proconlon/EC463_Team_01_Polar_Eyes/(commit log)

2025-11-03 Fixes to github actions - all actions can now be run locally with act (caching included for downloads) - removed HCL from pi4 build process as packer doesn't have decent arm builders out there - So t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
2025-11-03 fixed arduino actions and fixed fw artifact check
2025-11-03 fix to arduino build dir for artifact
2025-11-06 Updated to a better local img build process - moved img building code out of github actions file into a separate bash script - can now build using local_builder.sh, act/local github actions, or using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
2025-11-21 feat: full demo version of arduino always-on device (#5)
2026-04-30 update Spring 26 - Moved Pi 5 scripts to new worker_pi_five/ directory - Renamed Arduino folder to sentry_itsybitsy/ for hardware accuracy - Removed redundant legacy folders and massive log files - D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
    [polar_listener.py, sensor_logger.py, sentry_itsybitsy.ino, simple_timelapse.py, timelapse.py]
2026-04-30 added readme for camera control
2026-05-01 add enclosure image
